alexcrrera/leonidas-lander/notes/Weight Budget.xlsx

LEONIDAS V3 LANDER WEIGHT BUDGET
Item | Q | Mass | Total |  |  |  |  |  |  |  |  |  |  |  | Item | Quantity | Weight | Ah | S | S*kg/Ah
Landing legs | 4 | 27 | 108 | g |  |  |  | Total | 1657 | g | : | weighted |  |  | Turnigy Nano-Tech Plus 3000mAh 3S 70C LiPo Battery Pack w/XT90 (https://mail.google.com/mail/u/0/) | 4 | 287 | 3 | 3 | 0.03188888889
ESC (https://hobbyking.com/es_es/aerostar-100a-rvs-g2-32bit-2-6s-electronic-speed-controller-w-reverse-function-8a-5-6v-sbec.html) | 1 | 107 | 107 | g |  |  |  | Expected | 2000 | g | : | online |  |  | Turnigy Heavy Duty 5000mAh 3S 60C Lipo Pack w/XT-90 (https://mail.google.com/mail/u/0/) | 4 | 440 | 6 | 3 | 0.02444444444
Battery (https://hobbyking.com/en_us/turnigy-nano-tech-plus-3000mah-3s-70c-lipo-battery-pack-w-xt90.html) | 2 | 265 | 530 | g |  |  |  | Diff | 343 | g | : | estimated |  |  | Turnigy Heavy Duty 5000mAh 6S 60C LiPo Pack avec XT90 (https://hobbyking.com/fr_fr/turnigy-battery-heavy-duty-5000mah-6s-60c-lipo-pack-xt-90.html) | 2 | 838 | 5 | 6 | 0.02793333333
Edf holder |  |  | 0 | g
EDF (https://hobbyking.com/dr-mad-thrust-90mm-12-blade-alloy-edf-1600kv-motor-2100w-6s.html) | 1 | 440 | 440 | g |  |  |  | Structure | 343 | g
Telemetry & cable | 1 | 25 | 25 | g
VN300 & cable | 1 | 45 | 45 | g |  |  |  |  |  |  | 304.3 |  | 6
LiDAR & cable | 1 | 26 | 26 | g
OpticalFlow & cable | 1 | 12 | 12 |  |  |  |  |  |  |  | kgf | W | V | A
GNSS cable & antenna | 2 | 30 | 60 | g |  |  |  |  |  |  | 0.1 | 9.62281092 | 25.2 | 0.3818575762 | 1166 | 399
Profile 20cm | 4 | 19.5 | 78 | g |  | 164 | 86 |  |  |  | 0.25 | 38.0375 | 25.2 | 1.509424603 | 1100 | 1208 | 42
Servo Holder | 4 | 15 | 60 | g |  | 156 |  |  |  |  | 0.5 | 107.5862968 | 25.2 | 4.26929749
 |  |  |  |  |  |  |  |  |  |  | 1 | 304.3 | 25.2 | 12.07539683
Simple XT90 | 1 | 42 | 42 | g |  |  |  |  |  |  | 2 | 860.6903741 | 25.2 | 34.15437992
Flight Computer | 1 | 37 | 37 | g |  |  |  |  |  |  | 2.5 | 1202.851365 | 25.2 | 47.73219702
Structure Holder | 3 | 15 | 45 | g |  |  |  |  |  |  | 3 | 1581.189182 | 25.2 | 62.74560247
Cheminee AERO |  | 40 | 0 | g |  |  |  |  |  |  | 3.5 | 1992.5261 | 25.2 | 79.06849603
Transition |  | 11 | 0 | g |  |  |  |  |  |  | 3.8 | 2254.121635 | 25.2 | 89.44927121
Stator AERO | 1 | 30 | 30 | g
Carbon fiber tube (https://www.amazon.fr/sourcing-map-Carbone-Envelopp%C3%A9-Quadcopter/dp/B099881YNL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) | 2 | 6 | 12 | g
 |  |  | 0 | g
Partial assembly | +elec no batt | + bat |  |  |  | R
1170 | 1330 | 1860 |  |  | 168
 |  |  |  |  | 667 | 830
 |  |  |  | Batt | Elec | Str | Stat
 |  |  |  | 530 | 205 | 1130 | 30
 |  | Total | 1895
 |  |  |  |  | CARBON: 10g/ bar
