alexcrrera/leonidas-lander/(commit log)

2025-10-04 improved dt precision in position control pid
2026-06-18 lander servo library
2026-08-11 TELEM finished and optical flow implemented
    next step fixing output type, fxing optical flow projection (yaw), generate addNED, addROTATION prints...
    [CommsConfig.h, Lander.cpp, Lander.h, OpticalFlow.cpp, OpticalFlow.h, SensorConfig.h]
2026-08-14 rem extra code and simplified
    LiDAR andf optrical flow pending fix, code runs now
    [Lander.cpp, Lander.h, Lander_structs.h, Lidar.cpp, Lidar.h]
2026-08-14 minor lidar fix
2026-08-14 updated motor managing, added enablers
    deleted mixer and migrated it to the motor manager
2026-08-15 re implemented teletry output, fixed state structs
    [Lander.h, Lander_structs.h, TelemetryManager.cpp, Telemetry_debug_output.cpp, Telemetry_telemetry_output.cpp]
2026-08-15 command output feedback and placeholder, fixed misc
    added toggling of USB/RADIO
    [CommandHandler.cpp, CommandHandler.h, CommandHandler_utilities.cpp, CommsConfig.h, TelemetryManager.cpp, TelemetryManager.h, Telemetry_telemetry_output.cpp, Telemetry_utilities.h]
2026-08-15 LiDAE implemented and fixed returns
    [CommandHandler_utilities.cpp, CommsConfig.h, Lander.cpp, Lander.h, Lander_structs.h, LiDAR_utilities.h, Lidar.cpp, Lidar.h]
2026-08-16 updated cmd error feedback
    [CommandHandler.h, CommandHandler_utilities.cpp]
2026-08-16 flight guard layer +motor manager override flags
    added safety override flags (including telem output)
2026-08-17 PID updated, handler added, added FlighRegime association
2026-08-17 rem spooling, added command to switch states and more
2026-08-17 PID upadte for altotude
    [Weight Budget.xlsx]
2026-08-19 update landing transitions and more
2026-09-04 implemented tau to deg conversion
    to do: build wrapper around Servo
    [Weight Budget.xlsx]
2026-09-06 Comms update and actuators revamp
2026-09-21 mass update
    [Weight Budget.xlsx]
2026-09-29 major update lost track lol
2026-09-29 fixed parameters and verified output.
    MIssing fixing mixer direction but ready for flight
    [ActuatorPWM.cpp, ActuatorPWM.h, ActuatorsConfig.h, Controller.cpp, FlightRegimeConfig.h, MotorManager.cpp, MotorManager_utilities.cpp, SafetyBounds.h]
2026-10-02 CAD images
